Dynastarter/LIN-Alternator-Tester/1.jpg

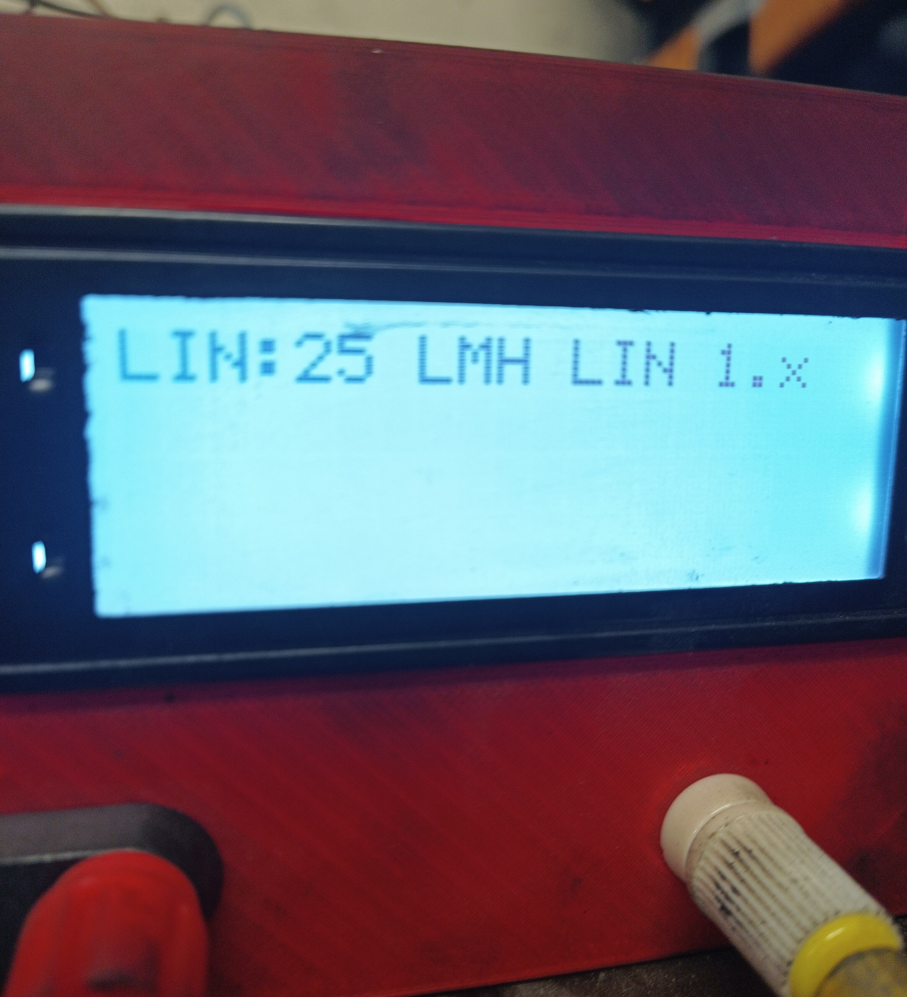
1.jpg
