Dynastarter/LIN-Alternator-Tester/3.jpg

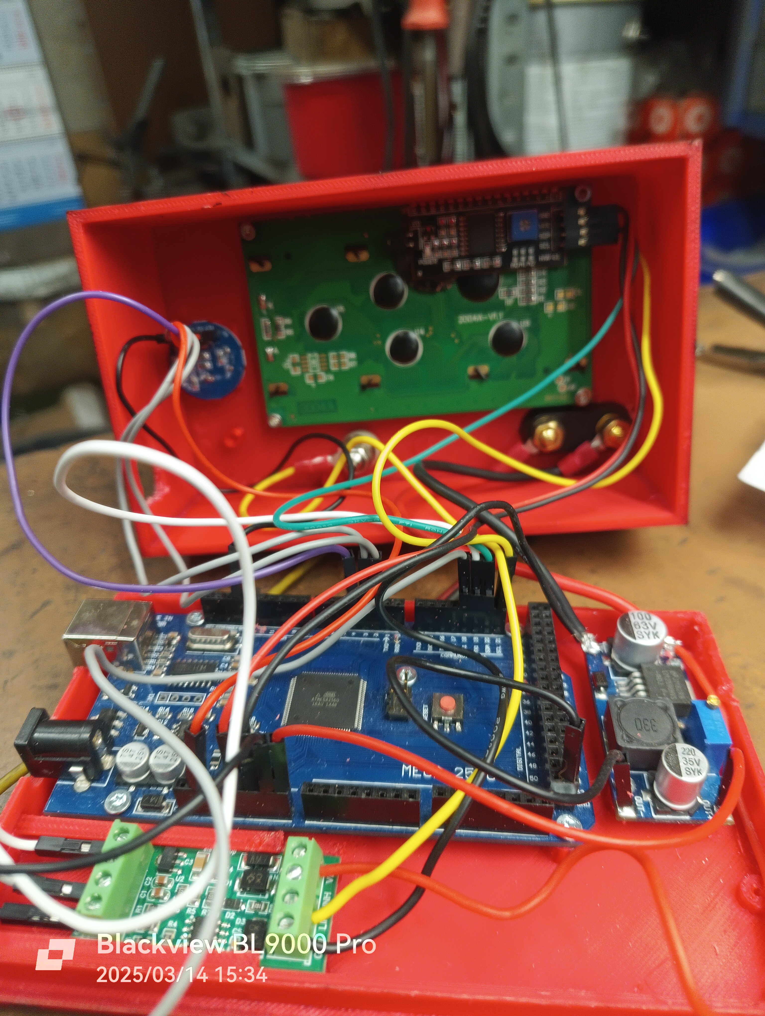
3.jpg
