Dynastarter/LIN-Alternator-Tester/12864.png

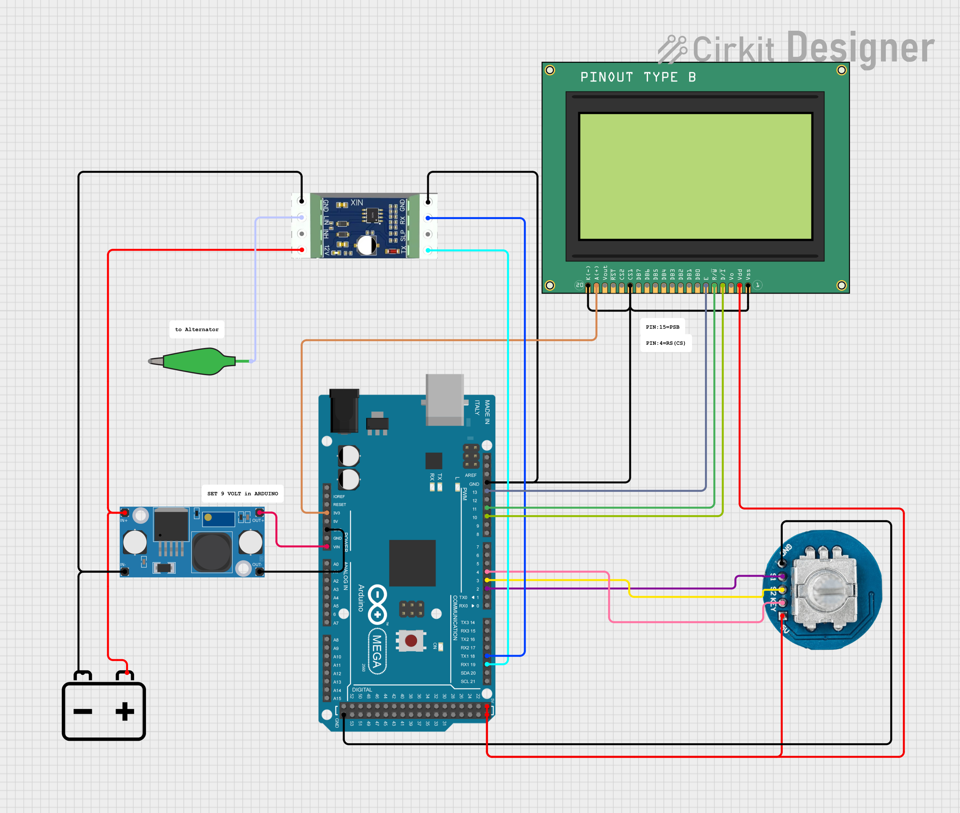
12864.png
