Dynastarter/LIN-Alternator-Tester/LCD2004.png

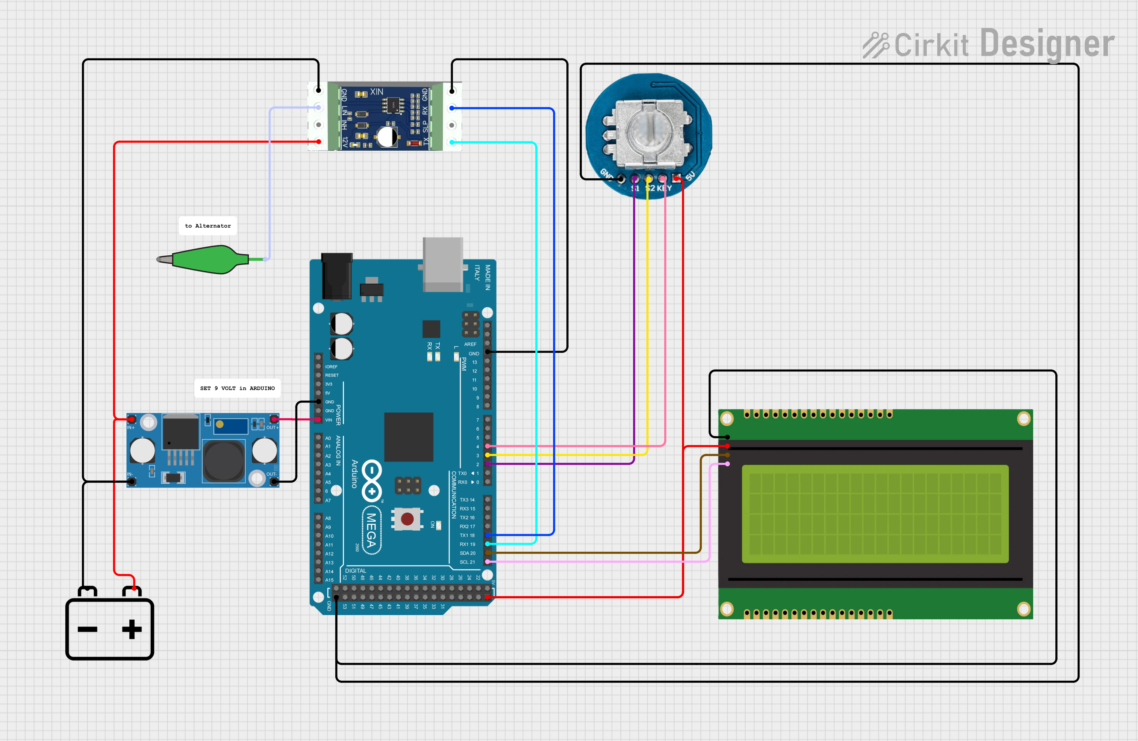
LCD2004.png
